W8Cat/Radioelectronics/LCF_V3/Schematic_V3.pdf

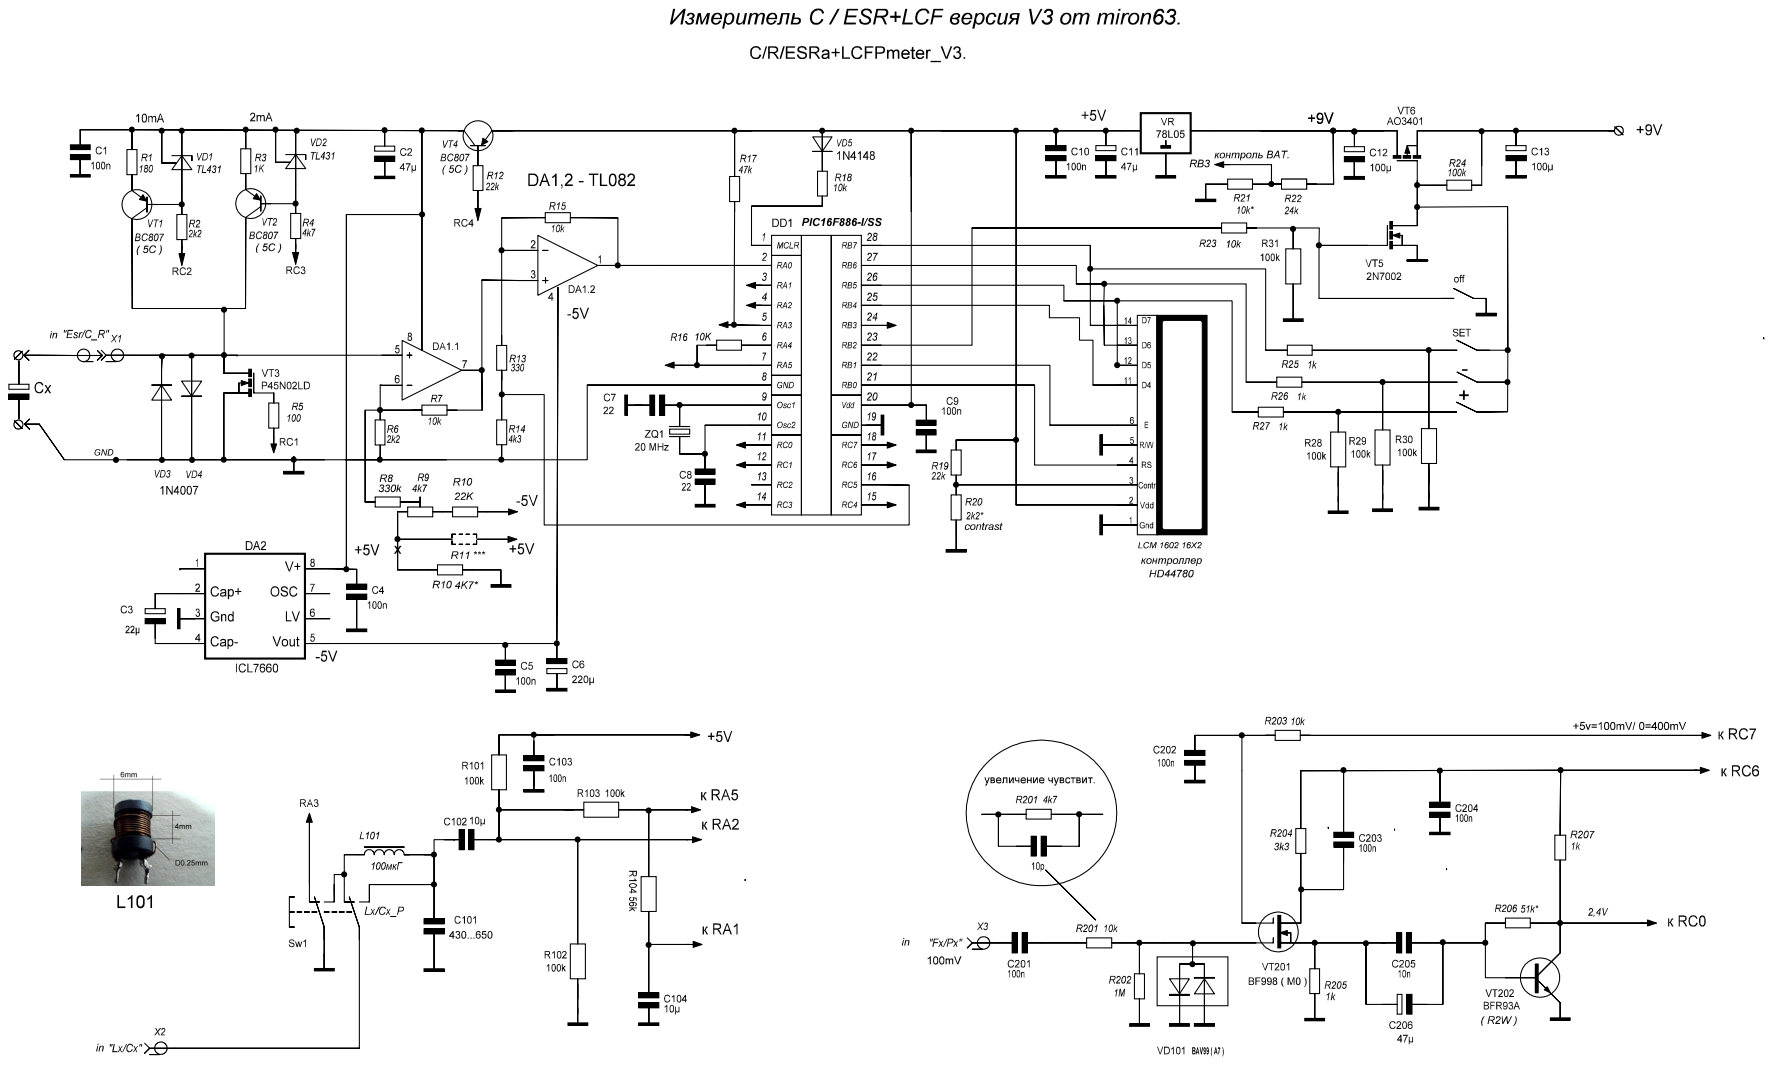
[picture p38: page 1]
