W8Cat/Radioelectronics/(list of files, drawings)

Other design files:
LCF_V3/PCB_V3.LAY 2x.lay6
LCF_V3/PCB_V3.LAY.lay6
